PanoramixDeDruide/LEDMetaMatrix/README.md

# LEDMetaMatrix
KiCad &amp; Arduino source files for a matrix of LED matrices.

Be sure to remove any comments from your .PBM source files!

Code only works with ASCII PBM files.

Sample picture
