PanoramixDeDruide/LEDMetaMatrix/GridMap/GridMap/GridMap.kicad_pcb

## KiCad design GridMap/GridMap/GridMap.kicad_pcb (2025-10-29)

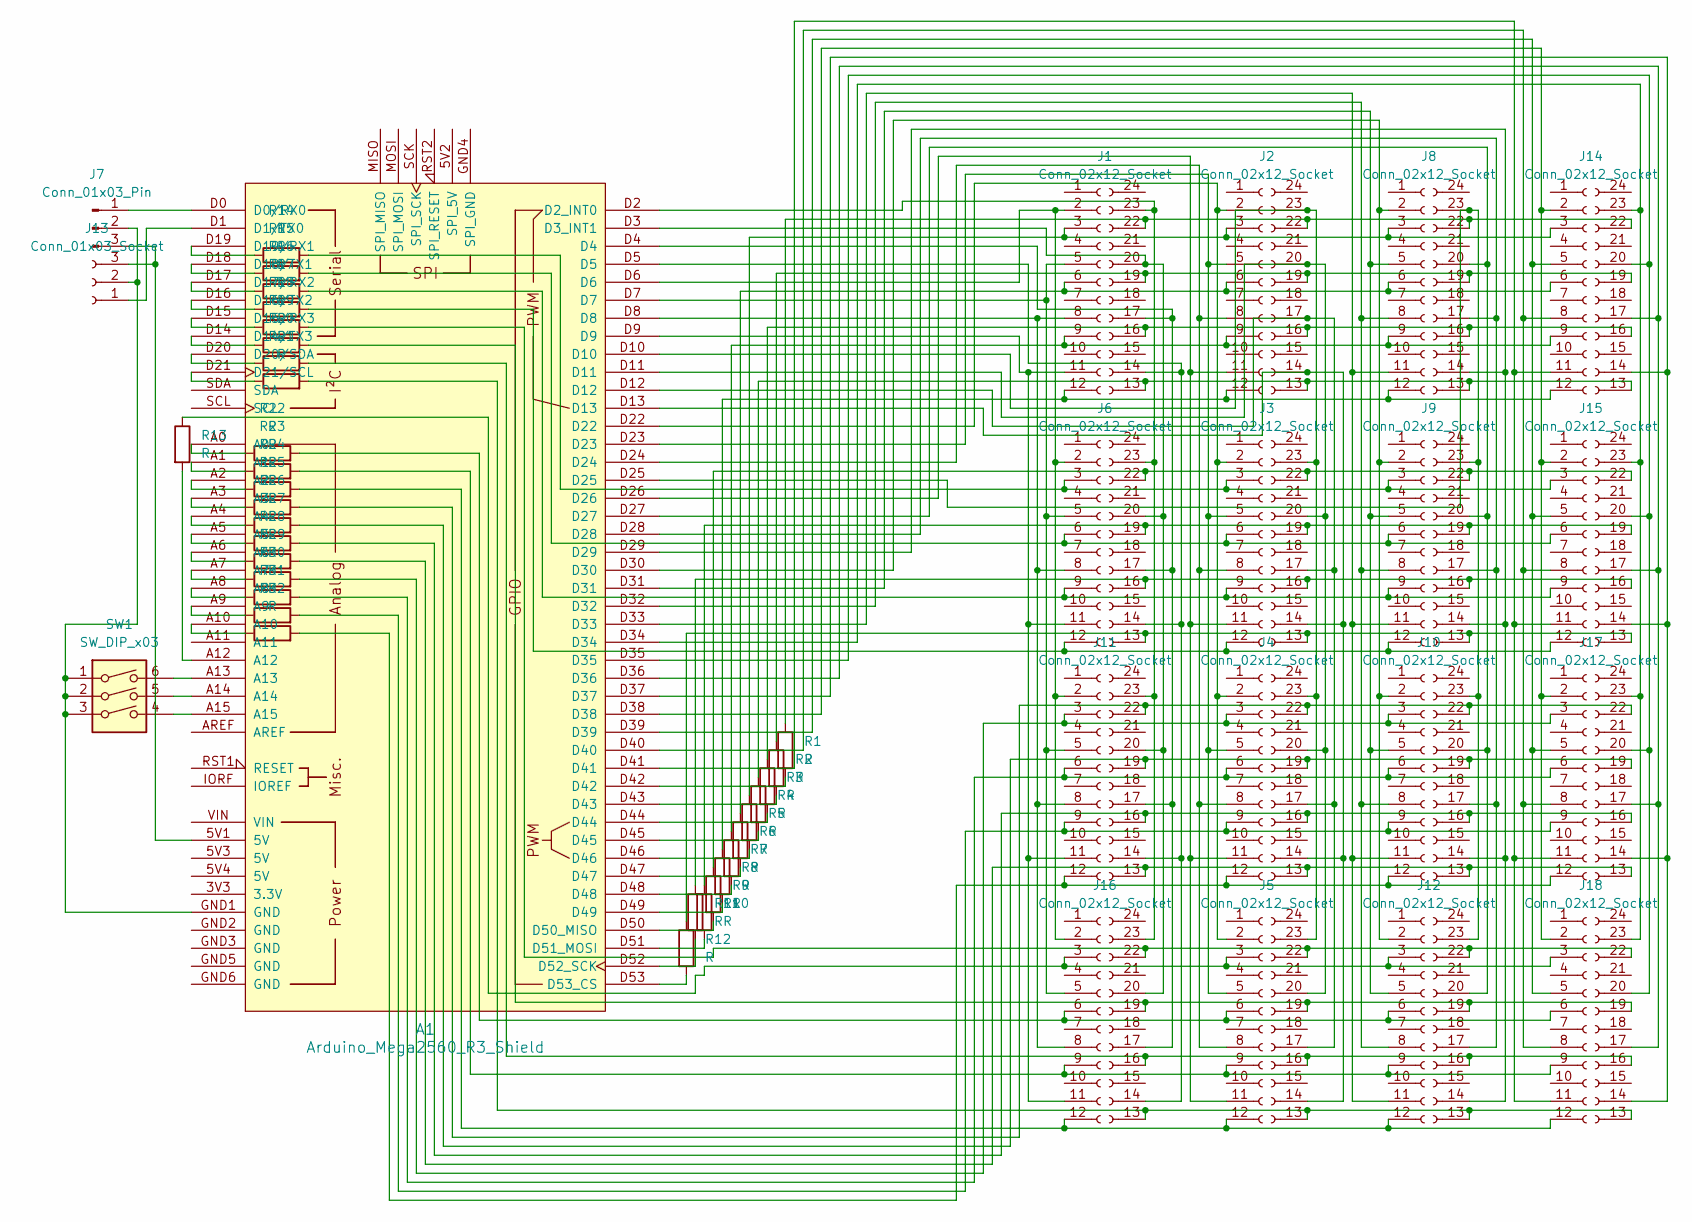
[picture p1: schematic GridMap.kicad_sch]

Parts:
A1: Arduino_Mega2560_R3_Shield
J1, J2, J3, J4, J5, J6, J8, J9, J10, J11, J12, J14, J15, J16, J17, J18: Conn_02x12_Socket; CSM-88181EG
J7: Conn_01x03_Pin; PinHeader_1x03_P2.54mm_Horizontal
J13: Conn_01x03_Socket; PinSocket_1x03_P2.54mm_Horizontal
R1, R2, R3, R4, R5, R6, R7, R8, R9, R10, R11, R12, R13, R14, R15, R16, R17, R18, R19, R20, R21, R22, R23, R24, R25, R26, R27, R28, R29, R30, R31, R32: R; R_Axial_DIN0207_L6.3mm_D2.5mm_P10.16mm_Horizontal
SW1: SW_DIP_x03; SW_DIP_SPSTx03_Slide_9.78x9.8mm_W7.62mm_P2.54mm

Connections:
unnamed: A1.D0 (D0/RX0), J7.1
unnamed: A1.D1 (D1/TX0), J13.1
unnamed: A1.D2 (D2_INT0), J1.23, J6.23, J11.23, J16.23
unnamed: A1.D3 (D3_INT1), J1.20, J6.20, J11.20, J16.20
unnamed: A1.D14 (D14/TX3), R19.1
unnamed: A1.D15 (D15/RX3), R18.1
unnamed: A1.D16 (D16/TX2), R17.1
unnamed: A1.D17 (D17/RX2), R16.1
unnamed: A1.D18 (D18/TX1), R15.1
unnamed: A1.D19 (D19/RX1), R14.1
unnamed: A1.D20 (D20/SDA), R20.1
unnamed: A1.D21 (D21/SCL), R21.1
unnamed: A1.D50 (D50_MISO), R9.2
unnamed: A1.D51 (D51_MOSI), R10.2
unnamed: A1.D52 (D52_SCK), R11.2
unnamed: A1.D53 (D53_CS), R12.2
unnamed: A1.A0, R22.1
unnamed: A1.A1, R23.1
unnamed: A1.A2, R24.1
unnamed: A1.A3, R25.1
unnamed: A1.A4, R26.1
unnamed: A1.A5, R27.1
unnamed: A1.A6, R28.1
unnamed: A1.A7, R29.1
unnamed: A1.A8, R30.1
unnamed: A1.A9, R31.1
unnamed: A1.A10, R32.1
unnamed: A1.A12, R13.2
unnamed: A1.A13, SW1.6
unnamed: A1.A14, SW1.5
unnamed: A1.A15, SW1.4
unnamed: A1.D42, R1.2
unnamed: A1.D43, R2.2
unnamed: A1.D44, R3.2
unnamed: A1.D45, R4.2
unnamed: A1.D46, R5.2
unnamed: A1.D47, R6.2
unnamed: A1.D48, R7.2
unnamed: A1.D49, R8.2
unnamed: A1.D6, J1.2, J6.2, J11.2, J16.2
unnamed: J1.3, J2.3, J8.3, J14.3, R5.1
unnamed: A1.D7, J1.5, J6.5, J11.5, J16.5
unnamed: J1.6, J2.6, J8.6, J14.6, R6.1
unnamed: A1.D8, J1.8, J6.8, J11.8, J16.8
unnamed: J1.9, J2.9, J8.9, J14.9, R7.1
unnamed: A1.D9, J1.11, J6.11, J11.11, J16.11
unnamed: J1.12, J2.12, J8.12, J14.12, R8.1
unnamed: J1.13, J2.13, J8.13, J14.13, R4.1
unnamed: A1.D5, J1.14, J6.14, J11.14, J16.14
unnamed: J1.16, J2.16, J8.16, J14.16, R3.1
unnamed: A1.D4, J1.17, J6.17, J11.17, J16.17
unnamed: J1.19, J2.19, J8.19, J14.19, R2.1
unnamed: J1.22, J2.22, J8.22, J14.22, R1.1
unnamed: A1.D22, J2.2, J3.2, J4.2, J5.2
unnamed: A1.D23, J2.5, J3.5, J4.5, J5.5
unnamed: A1.D24, J2.8, J3.8, J4.8, J5.8
unnamed: A1.D26, J2.11, J3.11, J4.11, J5.11
unnamed: A1.D13, J2.14, J3.14, J4.14, J5.14
unnamed: A1.D12, J2.17, J3.17, J4.17, J5.17
unnamed: A1.D11, J2.20, J3.20, J4.20, J5.20
unnamed: A1.D10, J2.23, J3.23, J4.23, J5.23
unnamed: A1.D30, J8.2, J9.2, J10.2, J12.2
unnamed: J4.3, J10.3, J11.3, J17.3, R29.2
unnamed: A1.D31, J8.5, J9.5, J10.5, J12.5
unnamed: J4.6, J10.6, J11.6, J17.6, R30.2
unnamed: A1.D32, J8.8, J9.8, J10.8, J12.8
unnamed: J4.9, J10.9, J11.9, J17.9, R31.2
unnamed: A1.D33, J8.11, J9.11, J10.11, J12.11
unnamed: J4.12, J10.12, J11.12, J17.12, R32.2
unnamed: J4.13, J10.13, J11.13, J17.13, R28.2
unnamed: A1.D29, J8.14, J9.14, J10.14, J12.14
unnamed: J4.16, J10.16, J11.16, J17.16, R27.2
unnamed: A1.D28, J8.17, J9.17, J10.17, J12.17
unnamed: J4.19, J10.19, J11.19, J17.19, R26.2
unnamed: A1.D27, J8.20, J9.20, J10.20, J12.20
unnamed: J4.22, J10.22, J11.22, J17.22, R25.2
unnamed: A1.D25, J8.23, J9.23, J10.23, J12.23
unnamed: J5.3, J12.3, J16.3, J18.3, R13.1
unnamed: J5.6, J12.6, J16.6, J18.6, R22.2
unnamed: J5.9, J12.9, J16.9, J18.9, R23.2
unnamed: J5.12, J12.12, J16.12, J18.12, R24.2
unnamed: J5.13, J12.13, J16.13, J18.13, R21.2
unnamed: J5.16, J12.16, J16.16, J18.16, R20.2
unnamed: J5.19, J12.19, J16.19, J18.19, R19.2
unnamed: J5.22, J12.22, J16.22, J18.22, R18.2
unnamed: A1.GND1 (GND), J7.2, J13.2, SW1.1, SW1.2, SW1.3
unnamed: A1.5V1 (5V), J7.3, J13.3
unnamed: A1.D38, J14.2, J15.2, J17.2, J18.2
unnamed: A1.D39, J14.5, J15.5, J17.5, J18.5
unnamed: A1.D40, J14.8, J15.8, J17.8, J18.8
unnamed: A1.D41, J14.11, J15.11, J17.11, J18.11
unnamed: A1.D37, J14.14, J15.14, J17.14, J18.14
unnamed: A1.D36, J14.17, J15.17, J17.17, J18.17
unnamed: A1.D35, J14.20, J15.20, J17.20, J18.20
unnamed: A1.D34, J14.23, J15.23, J17.23, J18.23
unnamed: J3.3, J6.3, J9.3, J15.3, R14.2
unnamed: J3.6, J6.6, J9.6, J15.6, R15.2
unnamed: J3.9, J6.9, J9.9, J15.9, R16.2
unnamed: J3.12, J6.12, J9.12, J15.12, R17.2
unnamed: J3.13, J6.13, J9.13, J15.13, R12.1
unnamed: J3.16, J6.16, J9.16, J15.16, R11.1
unnamed: J3.19, J6.19, J9.19, J15.19, R10.1
unnamed: J3.22, J6.22, J9.22, J15.22, R9.1

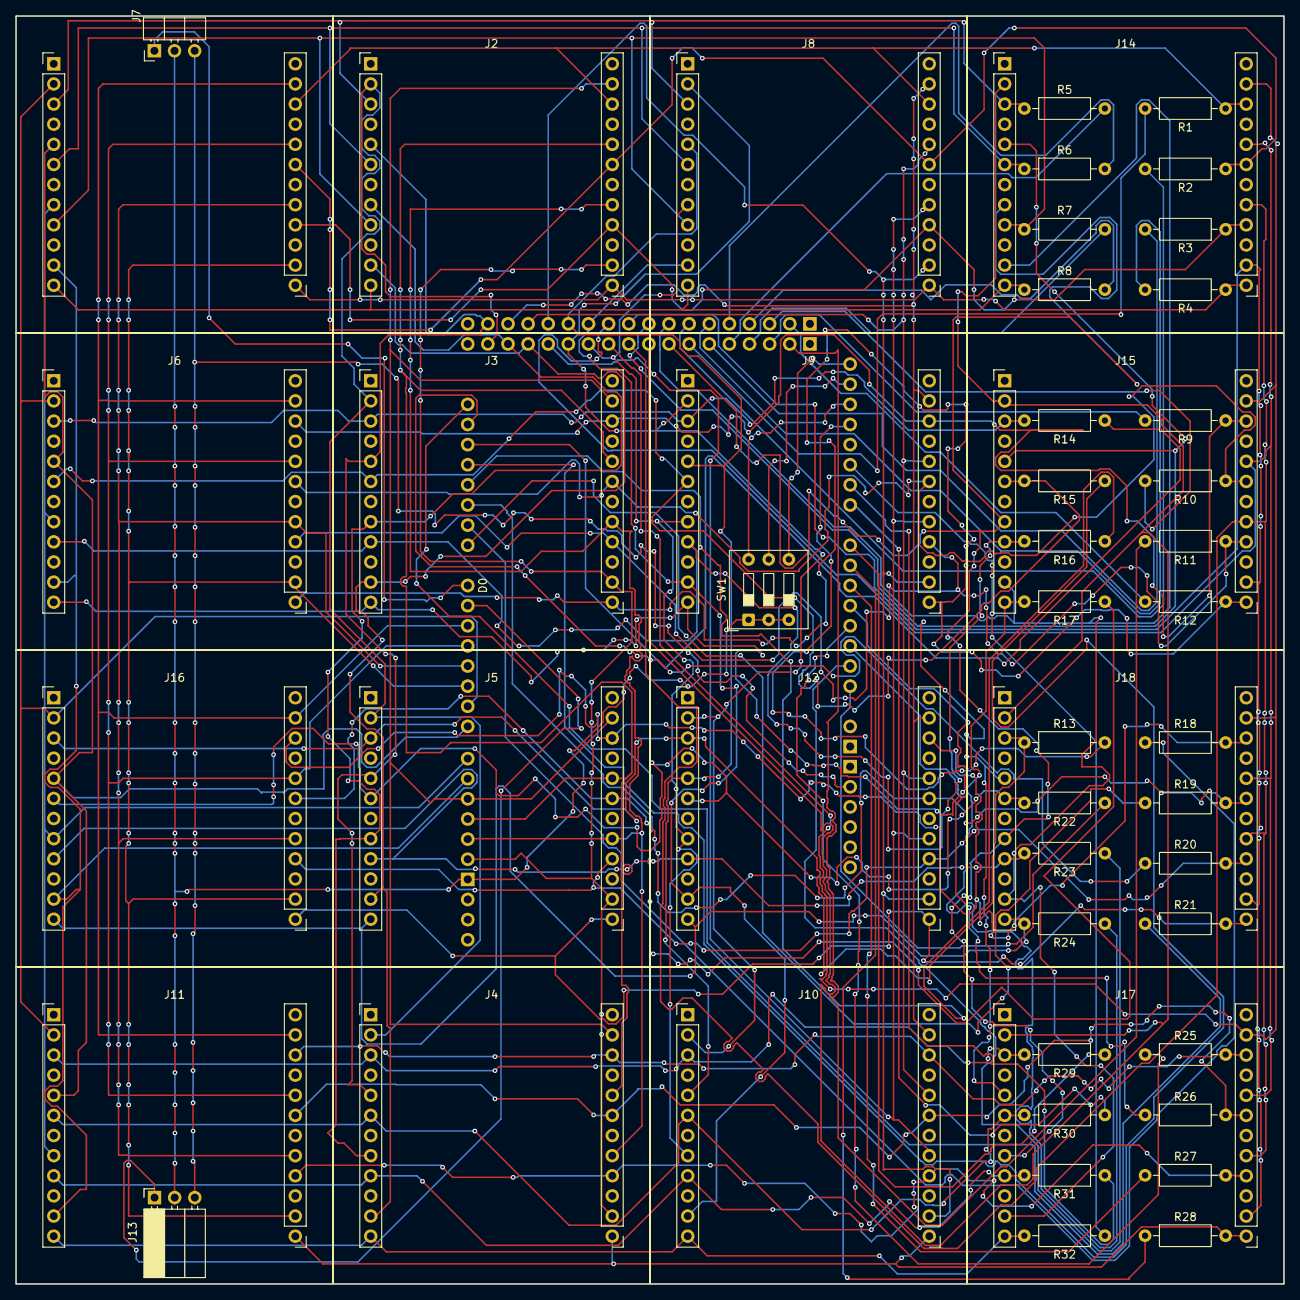
[picture p2: board GridMap.kicad_pcb from above]

Board: 2 copper layers, 160.0 x 160.0 mm, 52 parts (0 on the bottom side), 103 nets.
