PanoramixDeDruide/LEDMetaMatrix/(commit log)

2025-10-29 Added KiCad source files
    [GridMap.kicad_pcb, GridMap.kicad_sch]
2025-10-29 Added Arduino source file and KiCad footprint/symbol for CSM-88181EG LED matrix
2025-10-29 Added sample source files.
2025-10-29 Added rough version of BOM, subject to change.
